reivax-boucoi/Chess_table/README.md

# Chess_table
Automated chess table with magnets &amp; CoreXY
