reivax-boucoi/Chess_table/Electronics/controller_PCB_3D_back.png

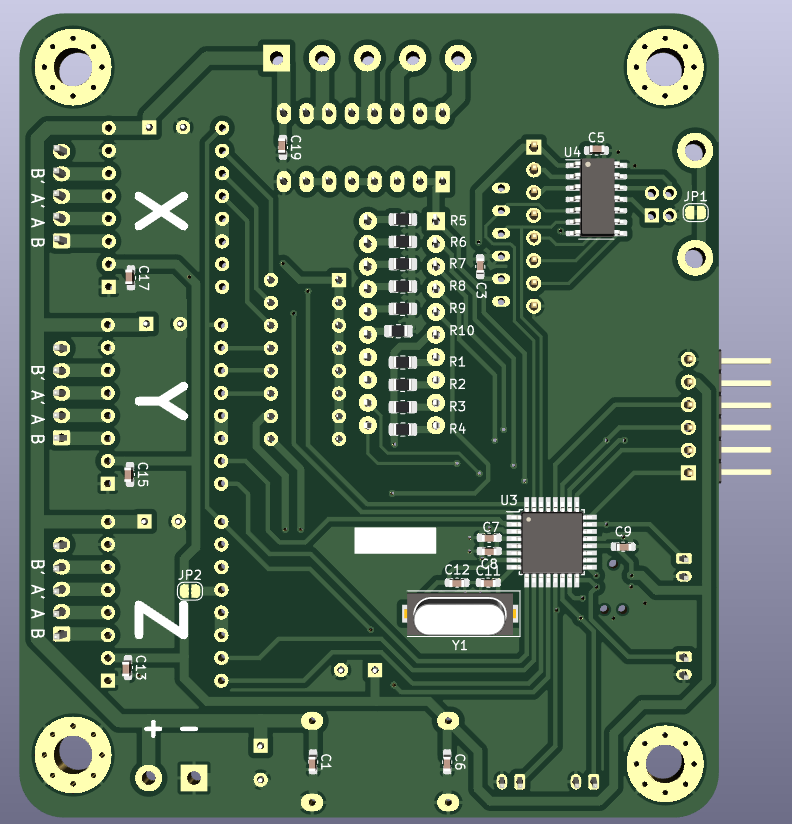
Electronics/controller_PCB_3D_back.png
