reivax-boucoi/Chess_table/Electronics/controller_PCB_3D_front.png

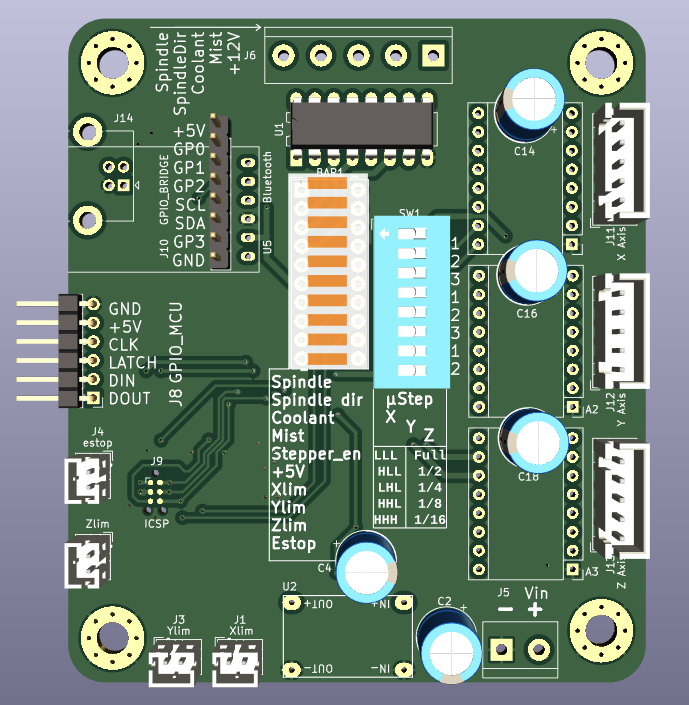
Electronics/controller_PCB_3D_front.png
