reivax-boucoi/Chess_table/Mechanicals/main.FCStd

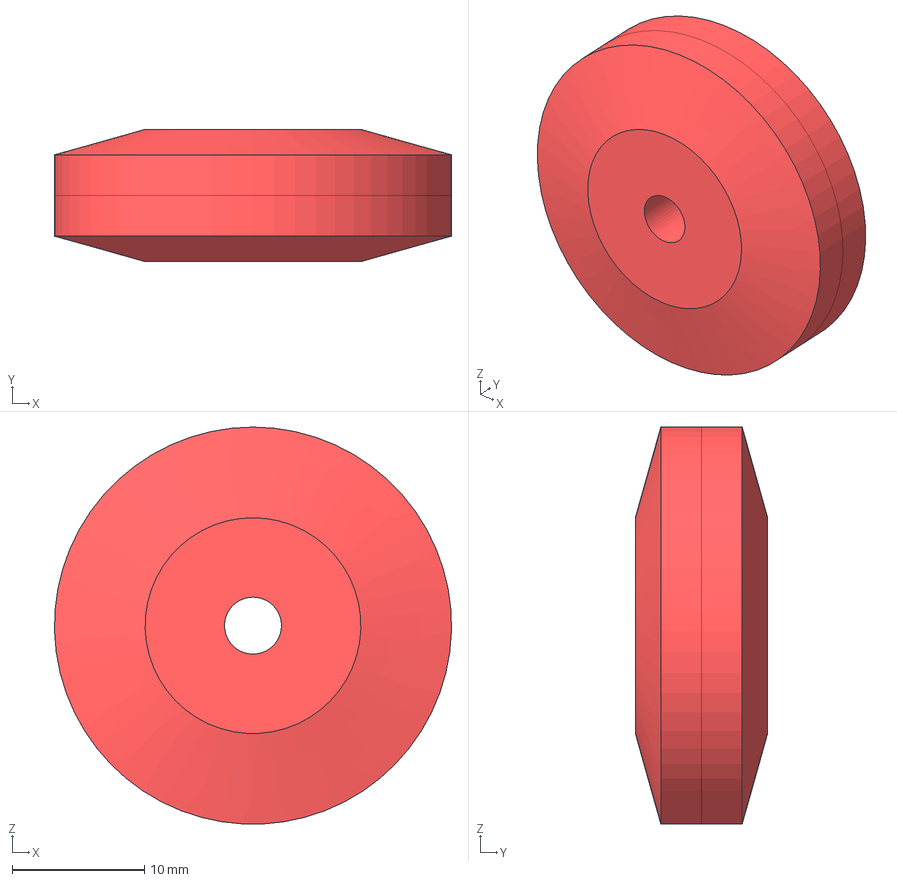
[picture p6: CAD file, 2023-09-05]
Mechanicals/main.FCStd
30.0 x 10.0 x 30.0 mm
