reivax-boucoi/Chess_table/Mechanicals/stl_exports/main-FreePulley.stl

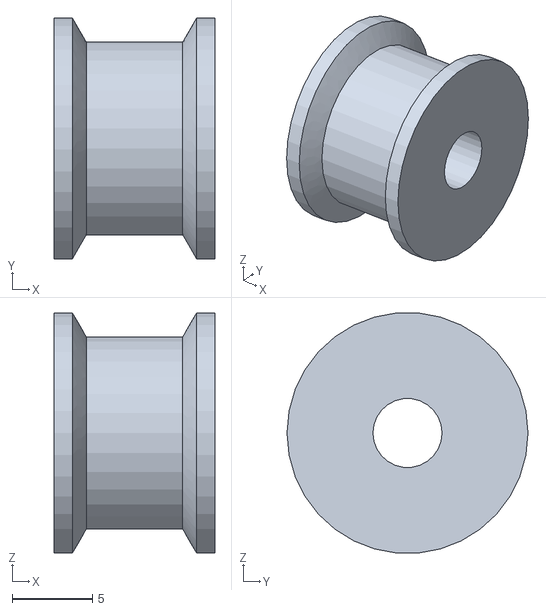
[picture p7: CAD file, 2023-09-05]
Mechanicals/stl_exports/main-FreePulley.stl
10.0 x 15.0 x 14.9
