reivax-boucoi/Chess_table/Mechanicals/stl_exports/main-Baseplate_botMirrored006.dxf

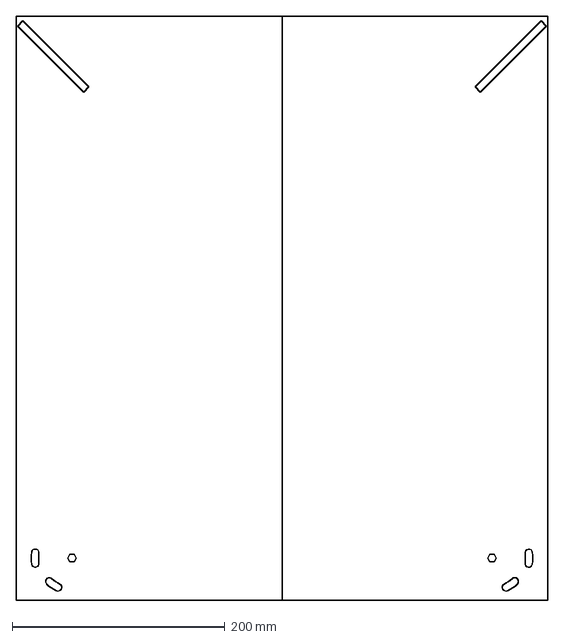
[picture p8: CAD file, 2023-09-02]
Mechanicals/stl_exports/main-Baseplate_botMirrored006.dxf
500.0 x 549.3 mm
