reivax-boucoi/Chess_table/Mechanicals/stl_exports/main-Baseplate_topMirrored005.dxf

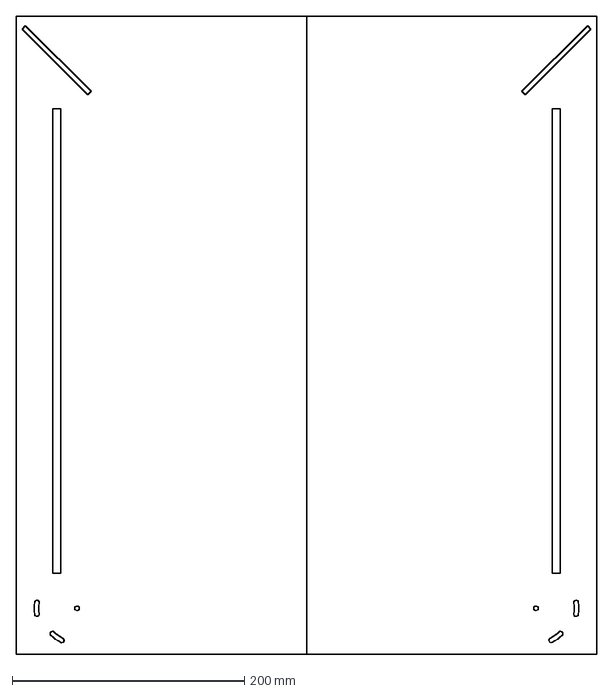
[picture p9: CAD file, 2023-09-02]
Mechanicals/stl_exports/main-Baseplate_topMirrored005.dxf
500.0 x 549.3 mm
