reivax-boucoi/Chess_table/Mechanicals/dual_pulley_assy.FCStd

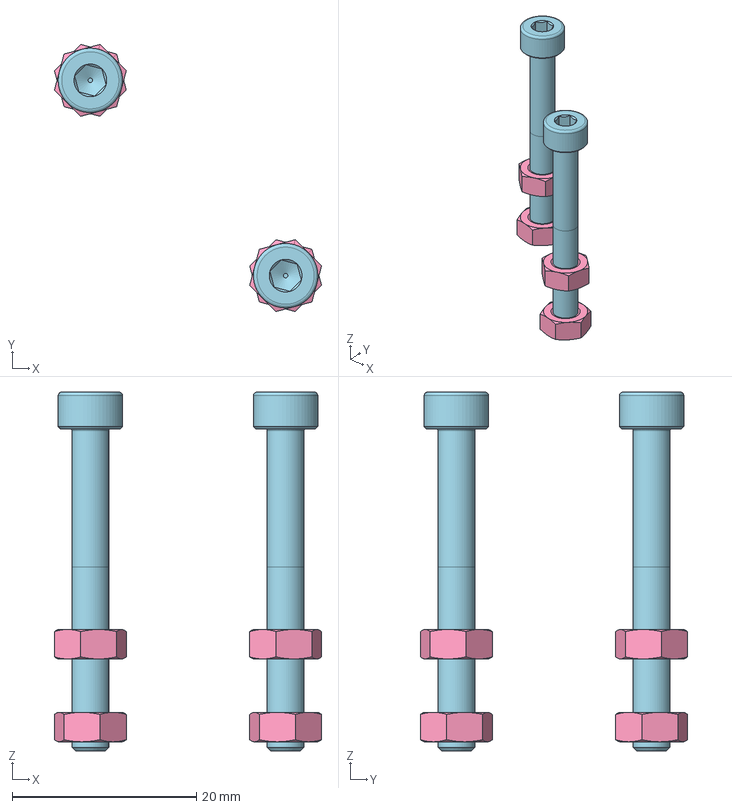
[picture p10: CAD file, 2023-08-26]
Mechanicals/dual_pulley_assy.FCStd
29.0 x 29.0 x 39.0 mm
M4-Nut
M4-Nut059
M4x35-Screw
M4x35-Screw001
M4-Nut060
M4-Nut061
