reivax-boucoi/Chess_table/Mechanicals/stl_exports/main-gantry_carriage.stl

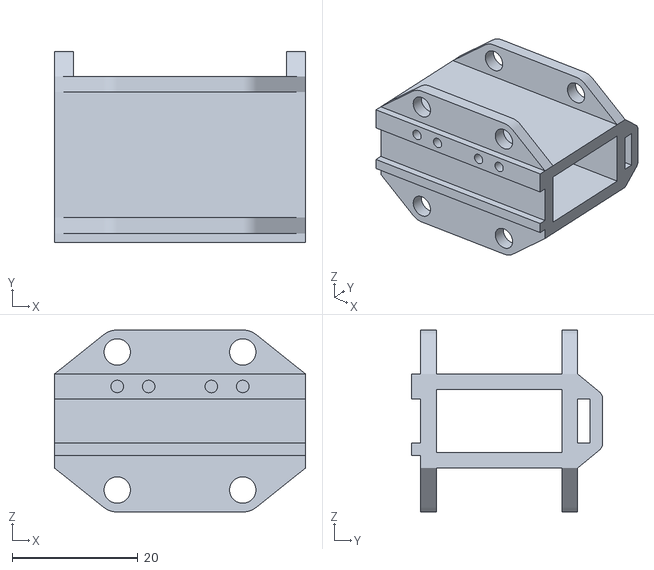
[picture p11: CAD file, 2023-09-02]
Mechanicals/stl_exports/main-gantry_carriage.stl
40.0 x 30.5 x 29.0
