reivax-boucoi/Chess_table/Mechanicals/stl_exports/main-Corner_tensionner.stl

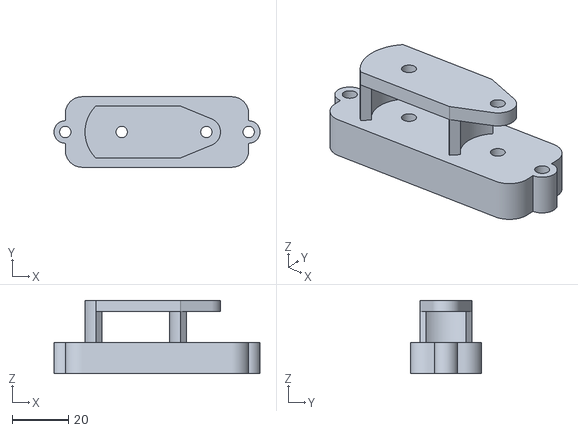
[picture p12: CAD file, 2023-09-02]
Mechanicals/stl_exports/main-Corner_tensionner.stl
73.0 x 25.0 x 26.0
