reivax-boucoi/Chess_table/Mechanicals/gantry_assy.FCStd

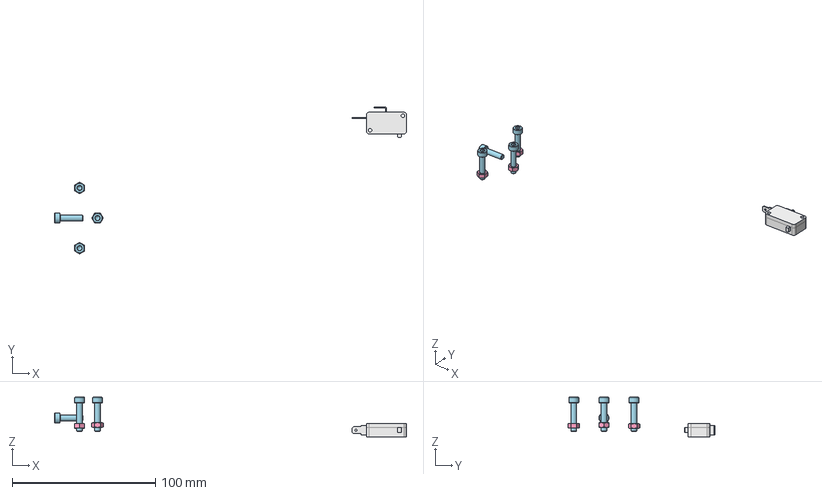
[picture p13: CAD file, 2023-08-26]
Mechanicals/gantry_assy.FCStd
245.5 x 102.5 x 27.6 mm
M4x20-Screw
M4-Nut
M4-Nut133
M4-Nut134
M4x20-Screw150
M4x20-Screw151
M4x16-Screw
Switch
