reivax-boucoi/Chess_table/Mechanicals/stl_exports/main-Gantry_rodSketch005.dxf

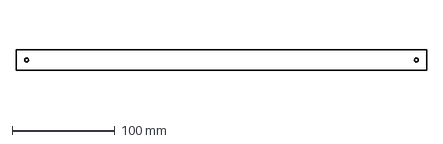
[picture p14: CAD file, 2023-09-02]
Mechanicals/stl_exports/main-Gantry_rodSketch005.dxf
400.0 x 20.0 mm
