reivax-boucoi/Chess_table/Mechanicals/stl_exports/main-Gantry_end.stl

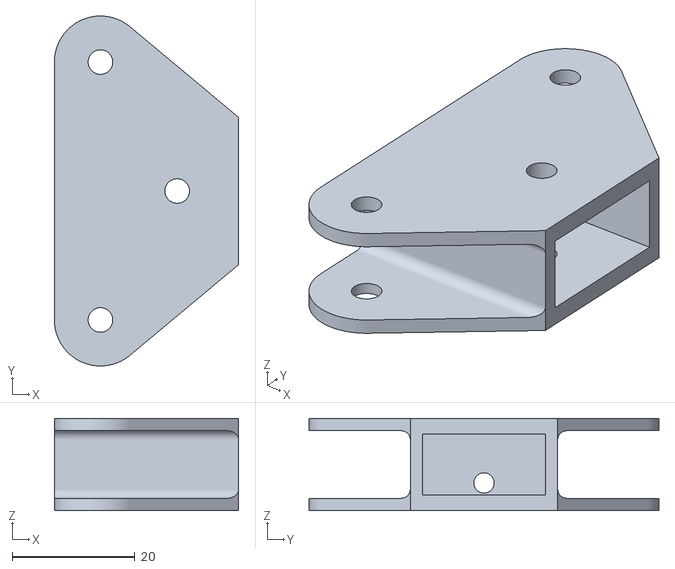
[picture p15: CAD file, 2023-09-02]
Mechanicals/stl_exports/main-Gantry_end.stl
30.0 x 57.0 x 15.0
