reivax-boucoi/Chess_table/Mechanicals/pieces.FCStd

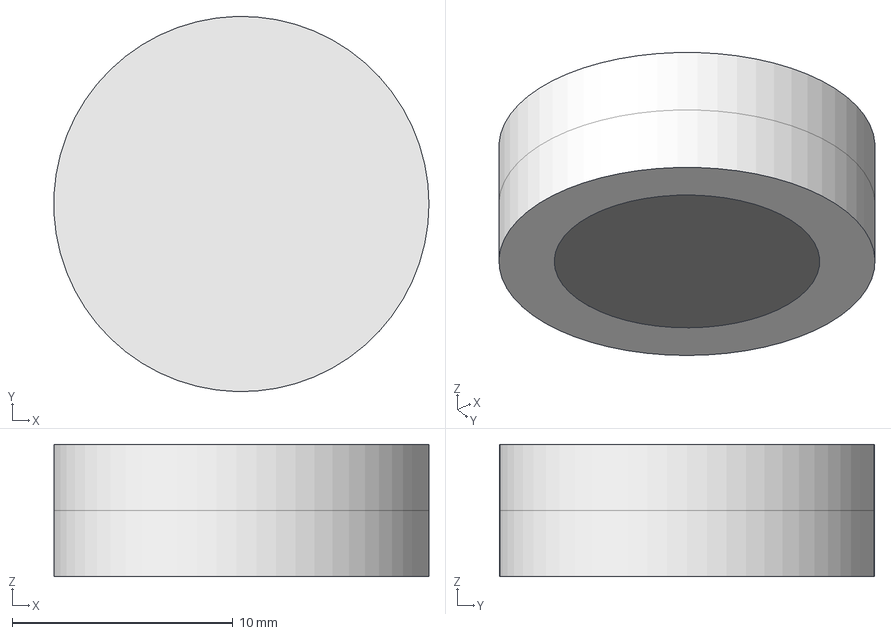
[picture p16: CAD file, 2023-10-23]
Mechanicals/pieces.FCStd
17.0 x 17.0 x 6.00 mm
Magnet
Piece_cover
