reivax-boucoi/Chess_table/Mechanicals/stl_exports/small_stepperMount-stepper_mount.stl

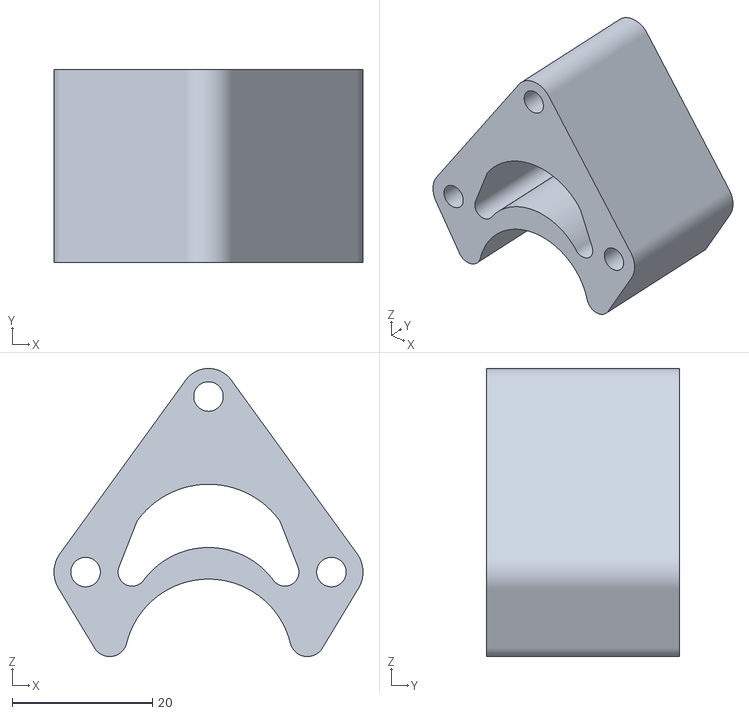
[picture p17: CAD file, 2023-10-22]
Mechanicals/stl_exports/small_stepperMount-stepper_mount.stl
44.0 x 27.5 x 41.0
