reivax-boucoi/Chess_table/Mechanicals/microswitch_spst.step

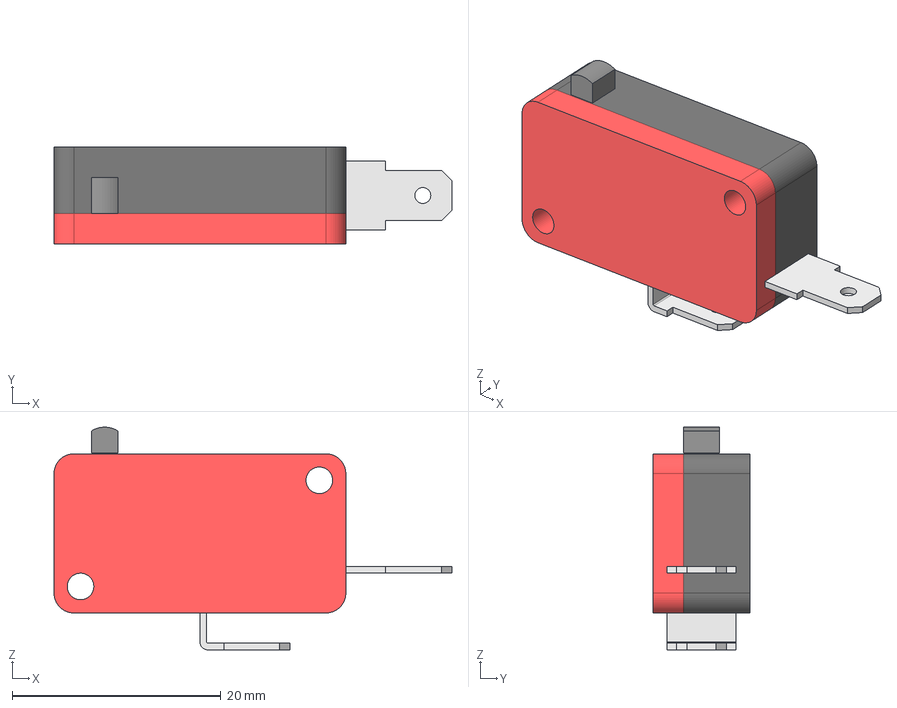
[picture p18: CAD file, 2023-08-26]
Mechanicals/microswitch_spst.step
38.1 x 9.25 x 21.3 mm
