reivax-boucoi/Chess_table/Mechanicals/28BYJ-48_stepper.stl

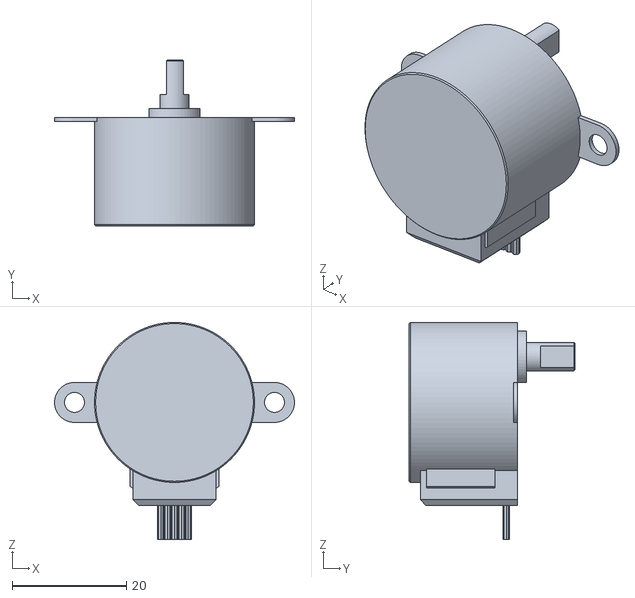
[picture p19: CAD file, 2023-08-26]
Mechanicals/28BYJ-48_stepper.stl
42.0 x 29.0 x 38.0
