reivax-boucoi/Chess_table/Mechanicals/big_stepperMount.FCStd

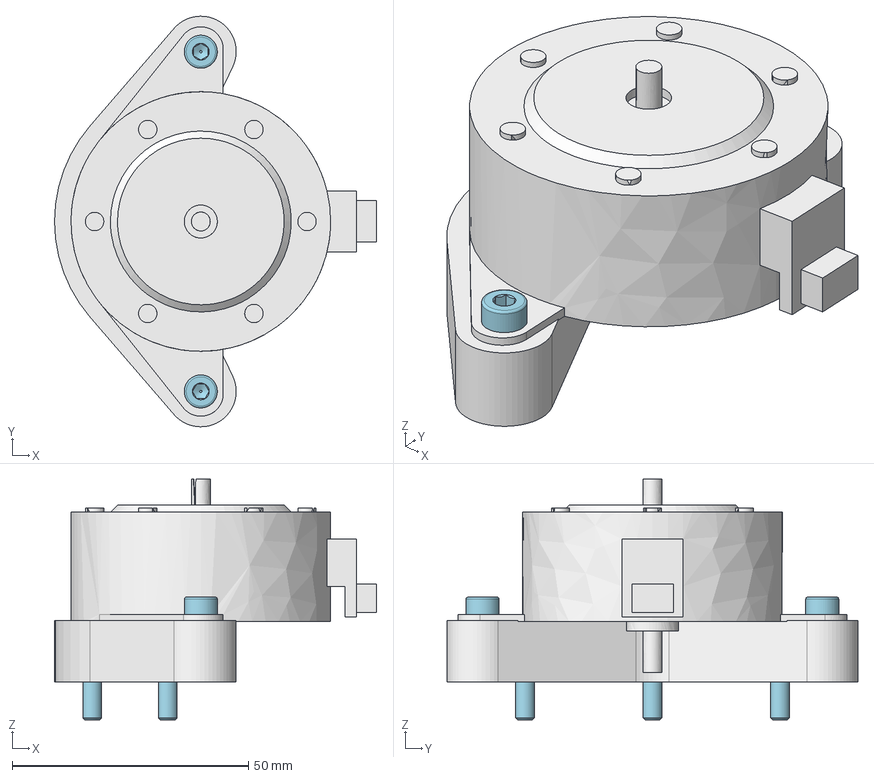
[picture p20: CAD file, 2023-08-26]
Mechanicals/big_stepperMount.FCStd
68.2 x 87.0 x 51.0 mm
PM55L_048 (Solid)
Motor_holder
M4-Nut
M4-Nut001
M4x14-Screw
M4x14-Screw017
M4x14-Screw018
M4x14-Screw019
M4x14-Screw020
