reivax-boucoi/Chess_table/Mechanicals/PM55L-048.igs

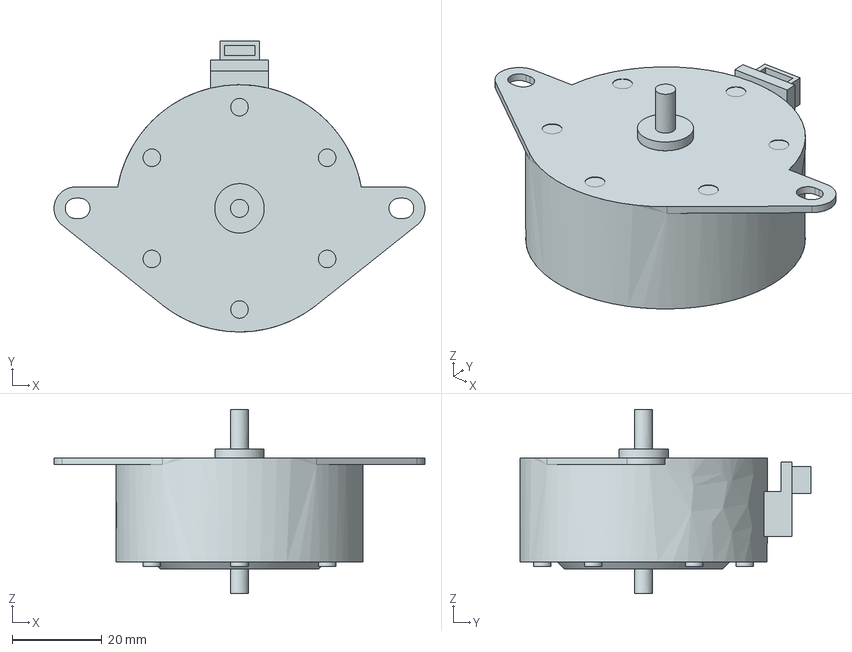
[picture p21: CAD file, 2023-08-26]
Mechanicals/PM55L-048.igs
82.5 x 64.7 x 41.0 mm
