reivax-boucoi/Chess_table/(list of files, cad)

Other CAD files:
Mechanicals/stl_exports/main-gantry_wheel.stl
Mechanicals/small_stepperMount.FCStd
