reivax-boucoi/Chess_table/Electronics/hall_sensor_matrix/hall_sensor_matrix.pdf

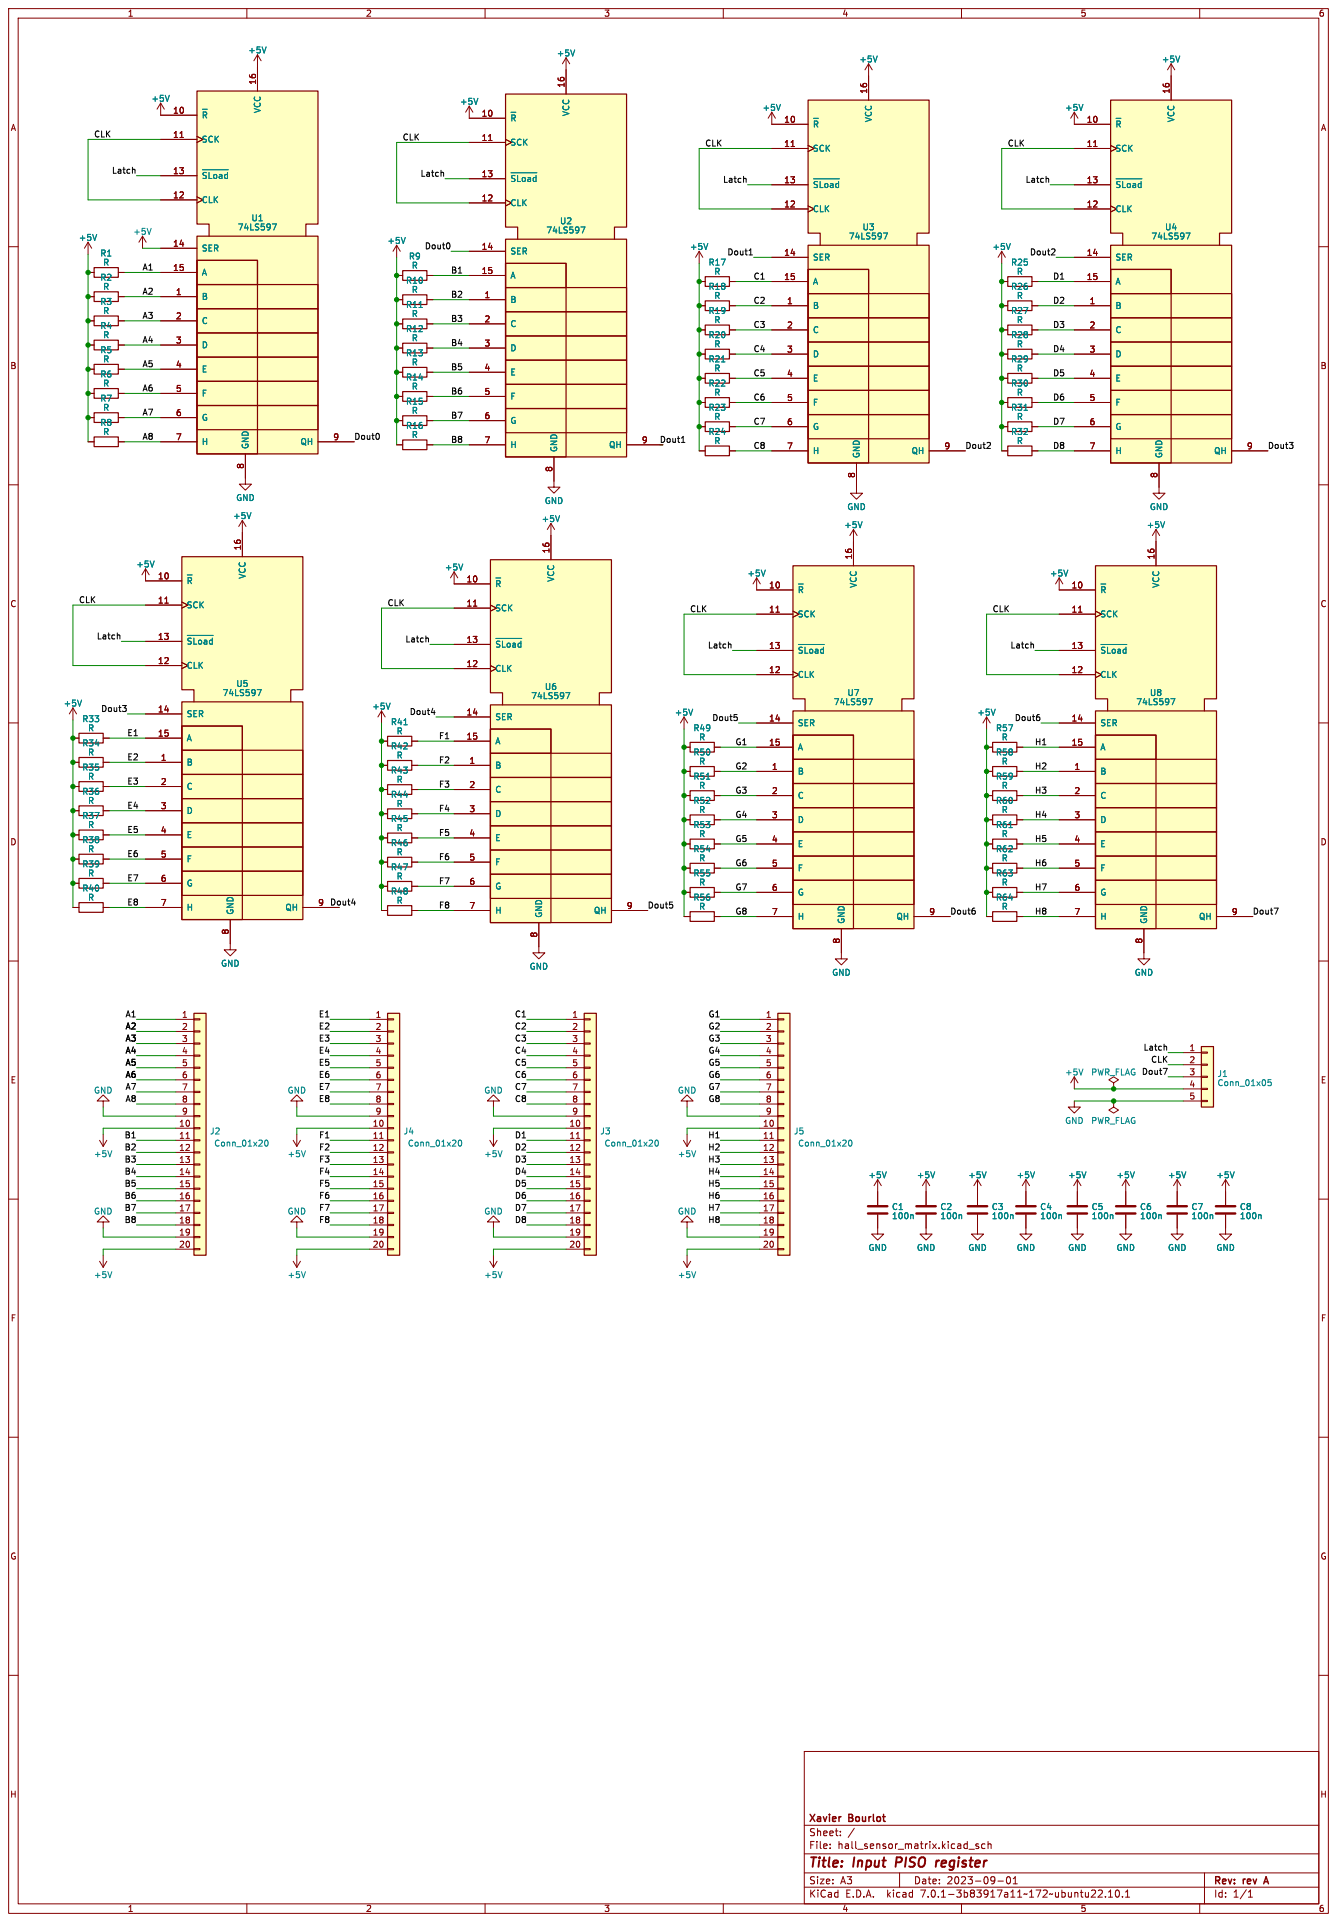
[picture p22: page 1]
