reivax-boucoi/Chess_table/Electronics/hall_sensor_matrix/hall_sensor_matrix.kicad_pcb

## KiCad design Electronics/hall_sensor_matrix/hall_sensor_matrix.kicad_pcb (2023-09-01)

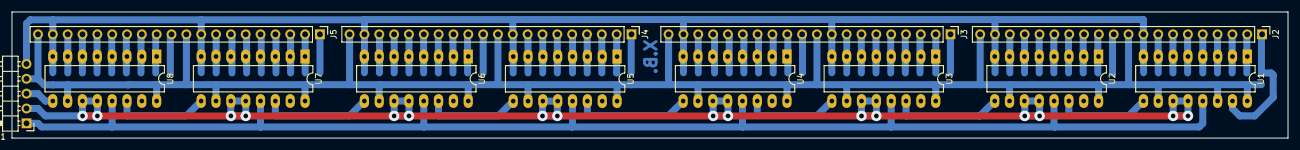
[picture p23: board hall_sensor_matrix.kicad_pcb from above]

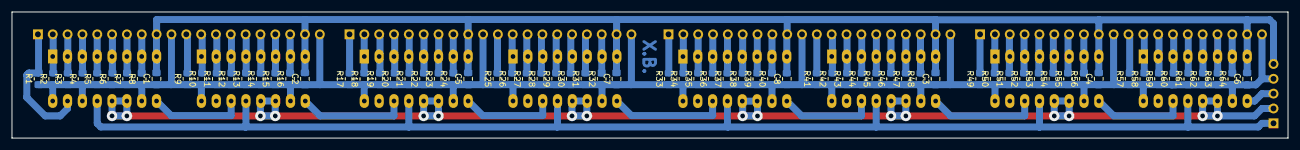
[picture p24: board hall_sensor_matrix.kicad_pcb from below]

Board: 2 copper layers, 218.4 x 21.6 mm, 85 parts (72 on the bottom side), 76 nets.

Parts:
C1, C2, C3, C4, C5, C6, C7: 100n; C_0805_2012Metric_Pad1.18x1.45mm_HandSolder
C8: 100n; R_0805_2012Metric_Pad1.20x1.40mm_HandSolder
J1: Conn_01x05; PinHeader_1x05_P2.54mm_Horizontal
J2, J3, J4, J5: Conn_01x20; PinHeader_1x20_P2.54mm_Vertical
R1, R2, R3, R4, R5, R6, R7, R8, R9, R10, R11, R12, R13, R14, R15, R16, R17, R18, R19, R20, R21, R22, R23, R24, R25, R26, R27, R28, R29, R30, R31, R32, R33, R34, R35, R36, R37, R38, R39, R40, R41, R42, R43, R44, R45, R46, R47, R48, R49, R50, R51, R52, R53, R54, R55, R56, R57, R58, R59, R60, R61, R62, R63, R64: R; R_0805_2012Metric_Pad1.20x1.40mm_HandSolder
U1, U2, U3, U4, U5, U6, U7, U8: 74LS597; DIP-16_W7.62mm_LongPads

Connections:
+5V: C1.1, C2.1, C3.1, C4.1, C5.1, C6.1, C7.1, C8.1, J1.4, J2.10, J2.20, J3.10, J3.20, J4.10, J4.20, J5.10, J5.20, R1.1, R2.1, R3.1, R4.1, R5.1, R6.1, R7.1, R8.1, R9.1, R10.1, R11.1, R12.1, R13.1, R14.1, R15.1, R16.1, R17.1, R18.1, R19.1, R20.1, R21.1, R22.1, R23.1, R24.1, R25.1, R26.1, R27.1, R28.1, R29.1, R30.1, R31.1, R32.1, R33.1, R34.1, R35.1, R36.1, R37.1, R38.1, R39.1, R40.1, R41.1, R42.1, R43.1, R44.1, R45.1, R46.1, R47.1, R48.1, R49.1, R50.1, R51.1, R52.1, R53.1, R54.1, R55.1, R56.1, R57.1, R58.1, R59.1, R60.1, R61.1, R62.1, R63.1, R64.1, U1.10 (~R), U1.14 (SER), U1.16 (VCC), U2.10 (~R), U2.16 (VCC), U3.10 (~R), U3.16 (VCC), U4.10 (~R), U4.16 (VCC), U5.10 (~R), U5.16 (VCC), U6.10 (~R), U6.16 (VCC), U7.10 (~R), U7.16 (VCC), U8.10 (~R), U8.16 (VCC)
/A1: J2.1, R1.2, U1.15 (A)
/A2: J2.2, R2.2, U1.1 (B)
/A3: J2.3, R3.2, U1.2 (C)
/A4: J2.4, R4.2, U1.3 (D)
/A5: J2.5, R5.2, U1.4 (E)
/A6: J2.6, R6.2, U1.5 (F)
/A7: J2.7, R7.2, U1.6 (G)
/A8: J2.8, R8.2, U1.7 (H)
/B1: J2.11, R9.2, U2.15 (A)
/B2: J2.12, R10.2, U2.1 (B)
/B3: J2.13, R11.2, U2.2 (C)
/B4: J2.14, R12.2, U2.3 (D)
/B5: J2.15, R13.2, U2.4 (E)
/B6: J2.16, R14.2, U2.5 (F)
/B7: J2.17, R15.2, U2.6 (G)
/B8: J2.18, R16.2, U2.7 (H)
/C1: J3.1, R17.2, U3.15 (A)
/C2: J3.2, R18.2, U3.1 (B)
/C3: J3.3, R19.2, U3.2 (C)
/C4: J3.4, R20.2, U3.3 (D)
/C5: J3.5, R21.2, U3.4 (E)
/C6: J3.6, R22.2, U3.5 (F)
/C7: J3.7, R23.2, U3.6 (G)
/C8: J3.8, R24.2, U3.7 (H)
/CLK: J1.2, U1.11 (SCK), U1.12 (CLK), U2.11 (SCK), U2.12 (CLK), U3.11 (SCK), U3.12 (CLK), U4.11 (SCK), U4.12 (CLK), U5.11 (SCK), U5.12 (CLK), U6.11 (SCK), U6.12 (CLK), U7.11 (SCK), U7.12 (CLK), U8.11 (SCK), U8.12 (CLK)
/D1: J3.11, R25.2, U4.15 (A)
/D2: J3.12, R26.2, U4.1 (B)
/D3: J3.13, R27.2, U4.2 (C)
/D4: J3.14, R28.2, U4.3 (D)
/D5: J3.15, R29.2, U4.4 (E)
/D6: J3.16, R30.2, U4.5 (F)
/D7: J3.17, R31.2, U4.6 (G)
/D8: J3.18, R32.2, U4.7 (H)
/Dout0: U1.9 (QH), U2.14 (SER)
/Dout1: U2.9 (QH), U3.14 (SER)
/Dout2: U3.9 (QH), U4.14 (SER)
/Dout3: U4.9 (QH), U5.14 (SER)
/Dout4: U5.9 (QH), U6.14 (SER)
/Dout5: U6.9 (QH), U7.14 (SER)
/Dout6: U7.9 (QH), U8.14 (SER)
/Dout7: J1.3, U8.9 (QH)
/E1: J4.1, R33.2, U5.15 (A)
/E2: J4.2, R34.2, U5.1 (B)
/E3: J4.3, R35.2, U5.2 (C)
/E4: J4.4, R36.2, U5.3 (D)
/E5: J4.5, R37.2, U5.4 (E)
/E6: J4.6, R38.2, U5.5 (F)
/E7: J4.7, R39.2, U5.6 (G)
/E8: J4.8, R40.2, U5.7 (H)
/F1: J4.11, R41.2, U6.15 (A)
/F2: J4.12, R42.2, U6.1 (B)
/F3: J4.13, R43.2, U6.2 (C)
/F4: J4.14, R44.2, U6.3 (D)
/F5: J4.15, R45.2, U6.4 (E)
/F6: J4.16, R46.2, U6.5 (F)
/F7: J4.17, R47.2, U6.6 (G)
/F8: J4.18, R48.2, U6.7 (H)
/G1: J5.1, R49.2, U7.15 (A)
/G2: J5.2, R50.2, U7.1 (B)
/G3: J5.3, R51.2, U7.2 (C)
/G4: J5.4, R52.2, U7.3 (D)
/G5: J5.5, R53.2, U7.4 (E)
/G6: J5.6, R54.2, U7.5 (F)
/G7: J5.7, R55.2, U7.6 (G)
/G8: J5.8, R56.2, U7.7 (H)
/H1: J5.11, R57.2, U8.15 (A)
/H2: J5.12, R58.2, U8.1 (B)
/H3: J5.13, R59.2, U8.2 (C)
/H4: J5.14, R60.2, U8.3 (D)
/H5: J5.15, R61.2, U8.4 (E)
/H6: J5.16, R62.2, U8.5 (F)
/H7: J5.17, R63.2, U8.6 (G)
/H8: J5.18, R64.2, U8.7 (H)
/Latch: J1.1, U1.13 (~SLoad), U2.13 (~SLoad), U3.13 (~SLoad), U4.13 (~SLoad), U5.13 (~SLoad), U6.13 (~SLoad), U7.13 (~SLoad), U8.13 (~SLoad)
GND: C1.2, C2.2, C3.2, C4.2, C5.2, C6.2, C7.2, C8.2, J1.5, J2.9, J2.19, J3.9, J3.19, J4.9, J4.19, J5.9, J5.19, U1.8 (GND), U2.8 (GND), U3.8 (GND), U4.8 (GND), U5.8 (GND), U6.8 (GND), U7.8 (GND), U8.8 (GND)
