reivax-boucoi/Chess_table/Electronics/controller/controller.kicad_pcb

## KiCad design Electronics/controller/controller.kicad_pcb (2023-08-26)

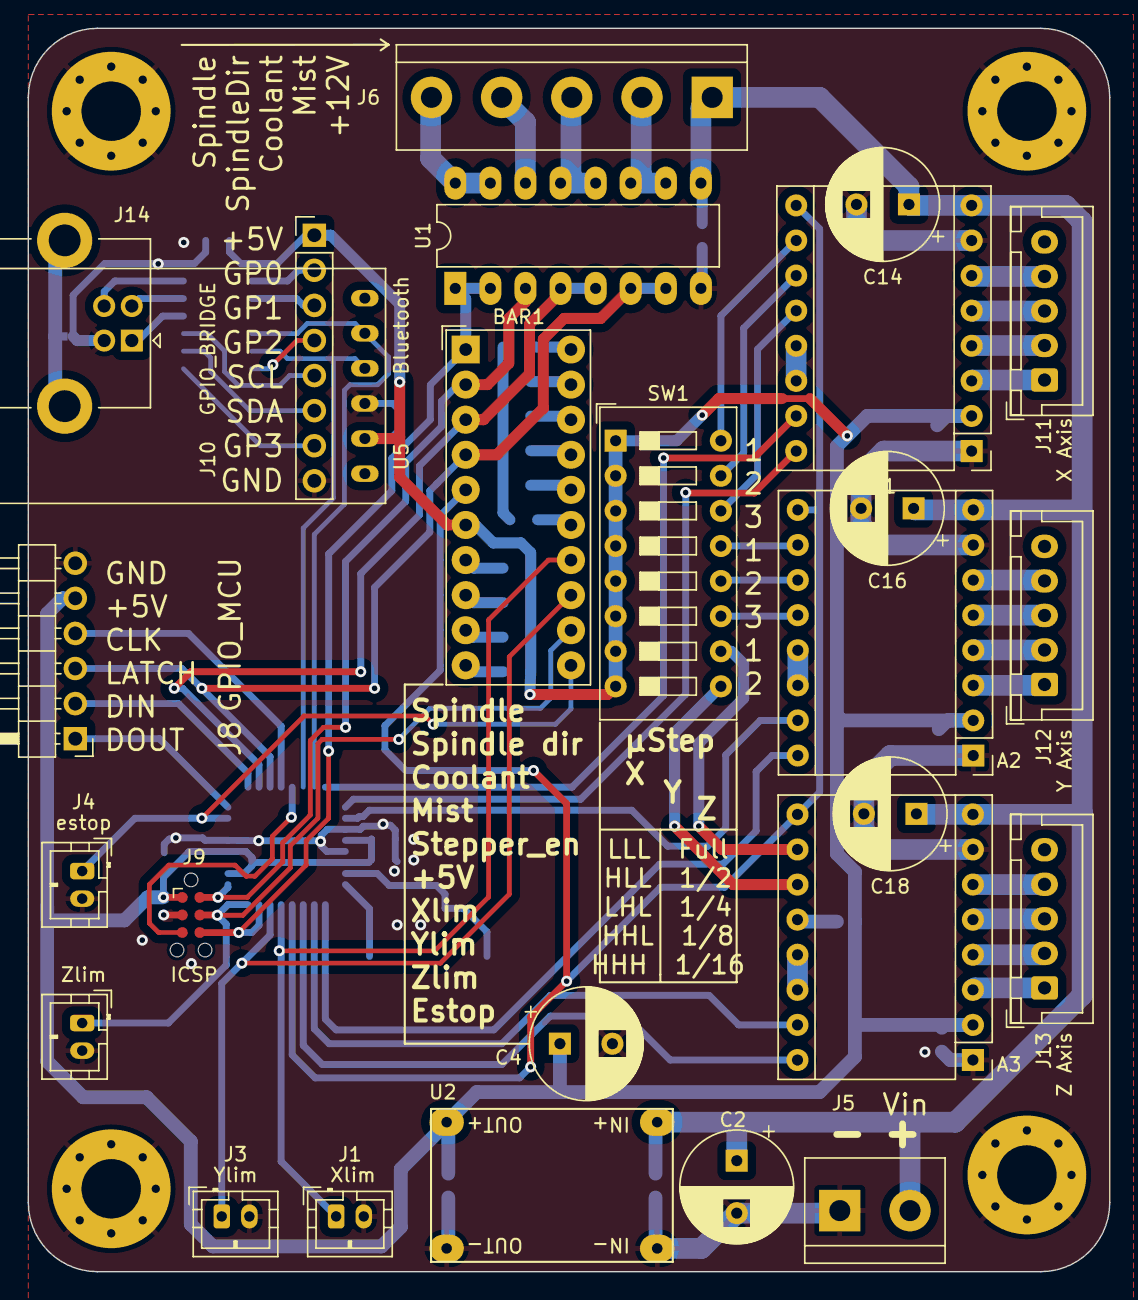
[picture p25: board controller.kicad_pcb from above]

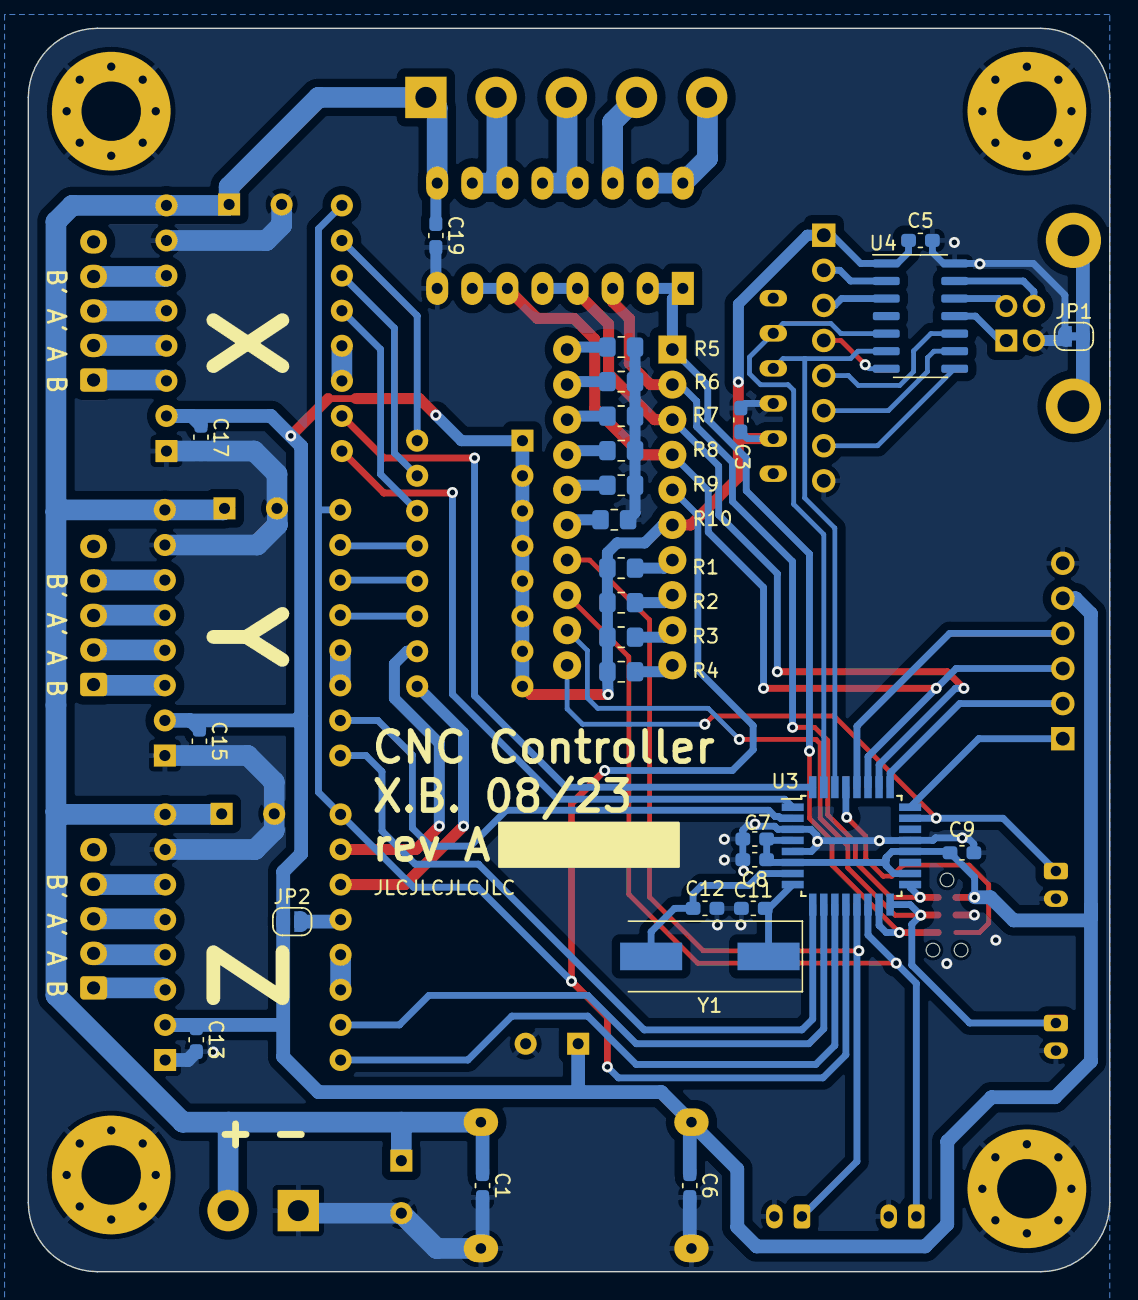
[picture p26: board controller.kicad_pcb from below]

Board: 2 copper layers, 78.3 x 90.0 mm, 58 parts (28 on the bottom side), 74 nets.

Parts:
A1, A2, A3: Pololu_Breakout_A4988; Pololu_Breakout-16_15.2x20.3mm
BAR1: HDSP-4830_2; HDSP-4830
C1, C3, C5, C6, C7, C8, C9, C13, C15, C17, C19: 100n; C_0603_1608Metric_Pad1.08x0.95mm_HandSolder
C2, C4, C14, C16, C18: 47u; CP_Radial_D8.0mm_P3.80mm
C11, C12: 22p; C_0603_1608Metric_Pad1.08x0.95mm_HandSolder
H1, H2, H3, H4: MountingHole_Pad; MountingHole_4.3mm_M4_Pad_Via
J1: Xlim; JST_PH_B2B-PH-K_1x02_P2.00mm_Vertical
J2: Zlim; JST_PH_B2B-PH-K_1x02_P2.00mm_Vertical
J3: Ylim; JST_PH_B2B-PH-K_1x02_P2.00mm_Vertical
J4: estop; JST_PH_B2B-PH-K_1x02_P2.00mm_Vertical
J5: Vin; TerminalBlock_bornier-2_P5.08mm
J6: Screw_Terminal_01x05; TerminalBlock_bornier-5_P5.08mm
J8: GPIO_MCU; PinHeader_1x06_P2.54mm_Horizontal
J9: ICSP; Tag-Connect_TC2030-IDC-NL_2x03_P1.27mm_Vertical
J10: GPIO_BRIDGE; PinHeader_1x08_P2.54mm_Vertical
J11: X Axis; JST_XH_B5B-XH-A_1x05_P2.50mm_Vertical
J12: Y Axis; JST_XH_B5B-XH-A_1x05_P2.50mm_Vertical
J13: Z Axis; JST_XH_B5B-XH-A_1x05_P2.50mm_Vertical
J14: USB_A; USB_B_Lumberg_2411_02_Horizontal
JP1: Jumper_2_Bridged; SolderJumper-2_P1.3mm_Bridged_RoundedPad1.0x1.5mm
JP2: Jumper_2_Open; SolderJumper-2_P1.3mm_Open_RoundedPad1.0x1.5mm
R1, R2, R3, R4, R5, R6, R7, R8, R9, R10: 1k; R_0805_2012Metric_Pad1.20x1.40mm_HandSolder
SW1: SW_DIP_x08; SW_DIP_SPSTx08_Slide_9.78x22.5mm_W7.62mm_P2.54mm
U1: ULN2003A; DIP-16_W7.62mm_LongPads
U2: Mini360; Mini360_step-down
U3: ATmega328P-A; TQFP-32_7x7mm_P0.8mm
U4: MCP2221AxSL; SOIC-14_3.9x8.7mm_P1.27mm
U5: Bluetooth; BlueSmirf
Y1: 16MHz; Crystal_SMD_HC49-SD

Connections:
+5V: A1.2 (VDD), A2.2 (VDD), A3.2 (VDD), BAR1.6 (A), C3.1, C4.1, C5.1, C6.1, C7.1, C8.1, C9.1, C13.1, C15.1, C17.1, J8.5, J9.1, J10.1, JP2.1 (A), R1.1, R2.1, R3.1, R4.1, SW1.1, SW1.2, SW1.3, SW1.4, SW1.5, SW1.6, SW1.7, SW1.8, U2.4 (OUT+), U3.4 (VCC), U3.6 (VCC), U3.18 (AVCC), U3.20 (AREF), U4.1 (VDD), U5.2 (VCC)
+12V: A1.8 (VMOT), A2.8 (VMOT), A3.8 (VMOT), C1.1, C2.1, C14.1, C16.1, C18.1, C19.1, J5.2, J6.1, U1.9 (COM), U2.2 (IN+)
/MCU/CLK: J8.4, U3.28 (PC5)
/MCU/DIN: J8.2, U3.25 (PC2)
/MCU/DOUT: J8.1, U3.24 (PC1)
/MCU/GP0: J10.2, U4.2 (GP0)
/MCU/GP1: J10.3, U4.3 (GP1)
/MCU/GP2: J10.4, U4.7 (GP2)
/MCU/GP3: J10.7, U4.8 (GP3)
/MCU/RX: U3.30 (PD0), U4.6 (UTx), U5.4 (TX)
/MCU/SCL: J10.5, U4.10 (SCL)
/MCU/SDA: J10.6, U4.9 (SDA)
/MCU/TX: U3.31 (PD1), U4.5 (URx), U5.5 (RX)
/MCU/VUSB: J14.1 (VBUS), U4.11 (VUSB)
/MCU/XTAL1: C12.1, U3.7 (XTAL1/PB6), Y1.2
/MCU/XTAL2: C11.1, U3.8 (XTAL2/PB7), Y1.1
/MCU/dirX: A1.16 (DIR), U3.1 (PD3)
/MCU/dirY: A2.16 (DIR), U3.9 (PD5)
/MCU/dirZ: A3.16 (DIR), U3.11 (PD7)
/MCU/stepX: A1.15 (STEP), U3.32 (PD2)
/MCU/stepY: A2.15 (STEP), U3.2 (PD4)
/MCU/stepZ: A3.15 (STEP), U3.10 (PD6)
/MCU/~RST: J9.5, U3.29 (~RESET/PC6)
/StepperDrivers/MS1_X: A1.10 (MS1), SW1.16
/StepperDrivers/MS1_Y: A2.10 (MS1), SW1.13
/StepperDrivers/MS1_Z: A3.10 (MS1), SW1.10
/StepperDrivers/MS2_X: A1.11 (MS2), SW1.15
/StepperDrivers/MS2_Y: A2.11 (MS2), SW1.12
/StepperDrivers/MS2_Z: A3.11 (MS2), SW1.9
/StepperDrivers/MS3_X: A1.12 (MS3), SW1.14
/StepperDrivers/MS3_Y: A2.12 (MS3), SW1.11
/StepperDrivers/MS3_Z: A3.12 (MS3), JP2.2 (B)
/coolant: BAR1.3 (A), U1.4 (I4), U1.5 (I5), U3.26 (PC3)
/estop: BAR1.11 (K), J4.1, U3.23 (PC0)
/mist: BAR1.4 (A), J8.3, U1.6 (I6), U1.7 (I7), U3.27 (PC4)
/spindle: BAR1.1 (A), J9.6, U1.1 (I1), U1.2 (I2), U3.15 (PB3)
/spindle_dir: BAR1.2 (A), J9.2, U1.3 (I3), U3.17 (PB5)
/stepper_enable: A1.9 (~ENABLE), A2.9 (~ENABLE), A3.9 (~ENABLE), BAR1.5 (A), U3.12 (PB0)
/xlim: BAR1.14 (K), J1.1, U3.13 (PB1)
/ylim: BAR1.13 (K), J3.1, U3.14 (PB2)
/zlim: BAR1.12 (K), J2.1, J9.4, U3.16 (PB4)
GND: A1.1 (GND), A1.7 (GND), A2.1 (GND), A2.7 (GND), A3.1 (GND), A3.7 (GND), C1.2, C2.2, C3.2, C4.2, C5.2, C6.2, C7.2, C8.2, C9.2, C11.2, C12.2, C13.2, C14.2, C15.2, C16.2, C17.2, C18.2, C19.2, H1.1, H2.1, H3.1, H4.1, J1.2, J2.2, J3.2, J4.2, J5.1, J8.6, J9.3, J10.8, J14.4 (GND), JP1.1 (A), R5.1, R6.1, R7.1, R8.1, R9.1, R10.1, U1.8 (GND), U2.1 (IN-), U2.3 (OUT-), U3.3 (GND), U3.5 (GND), U3.21 (GND), U4.14 (VSS), U5.3 (GND)
unnamed: A1.4 (1A), J11.2
unnamed: A1.3 (1B), J11.1
unnamed: A1.5 (2A), J11.3
unnamed: A1.6 (2B), J11.4
unnamed: A1.13 (~RESET), A1.14 (~SLEEP)
unnamed: A2.4 (1A), J12.2
unnamed: A2.3 (1B), J12.1
unnamed: A2.5 (2A), J12.3
unnamed: A2.6 (2B), J12.4
unnamed: A2.13 (~RESET), A2.14 (~SLEEP)
unnamed: A3.4 (1A), J13.2
unnamed: A3.3 (1B), J13.1
unnamed: A3.5 (2A), J13.3
unnamed: A3.6 (2B), J13.4
unnamed: A3.13 (~RESET), A3.14 (~SLEEP)
unnamed: BAR1.7 (A), R1.2
unnamed: BAR1.8 (A), R2.2
unnamed: BAR1.9 (A), R3.2
unnamed: BAR1.10 (A), R4.2
unnamed: BAR1.15 (K), R10.2
unnamed: BAR1.16 (K), R9.2
unnamed: BAR1.17 (K), R8.2
unnamed: BAR1.18 (K), R7.2
unnamed: BAR1.19 (K), R6.2
unnamed: BAR1.20 (K), R5.2
unnamed: J6.2, U1.10 (O7), U1.11 (O6)
unnamed: J6.3, U1.12 (O5), U1.13 (O4)
unnamed: J6.4, U1.14 (O3)
unnamed: J6.5, U1.15 (O2), U1.16 (O1)
unnamed: J14.3 (D+), U4.13 (D+)
unnamed: J14.2 (D-), U4.12 (D-)
unnamed: J14.5 (Shield), JP1.2 (B)
