reivax-boucoi/Chess_table/(commit log)

2023-08-26 added driver board
2023-08-26 added early mechanicals
    [28BYJ-48_stepper.stl, PM55L-048.igs, big_stepperMount.FCStd, dual_pulley_assy.FCStd, gantry_assy.FCStd, main.FCStd, microswitch_spst.step, small_stepperMount.FCStd]
2023-08-26 added board pics
2023-08-26 added board gerbers
    [controller-B_Cu.gbr, controller-B_Mask.gbr, controller-B_Paste.gbr, controller-B_Silkscreen.gbr, controller-Edge_Cuts.gbr, controller-F_Cu.gbr, controller-F_Mask.gbr, controller-F_Paste.gbr]
2023-08-28 added custome grbl
    [config.h, cpu_map.h, defaults.h]
2023-08-29 updated custom grbl
2023-09-01 added hall piso brd
    [hall_sensor_matrix.kicad_pcb, hall_sensor_matrix.kicad_sch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]
2023-09-02 added stl models
    [main-Baseplate_botMirrored006.dxf, main-Baseplate_topMirrored005.dxf, main-Corner_tensionner.stl, main-FreePulley.stl, main-Gantry_end.stl, main-Gantry_rodSketch005.dxf, main-gantry_carriage.stl, main-gantry_wheel.stl]
