reivax-boucoi/Chess_table/(notices)

Notices in the files:
Software/MCU/grbl-1.1h.20190825/grbl/cpu_map.h:
Grbl is free software: you can redistribute it and/or modify
it under the terms of the GNU General Public License as published by
the Free Software Foundation, either version 3 of the License, or
(at your option) any later version.
Software/MCU/grbl-1.1h.20190825/grbl/config.h:
Copyright (c) 2009-2011 Simen Svale Skogsrud
